Beyzaydinn/LifeLine/README.md

# CEN322 — Offline Voice First-Aid Assistant

**Your hardware only** — no extra push button required.

| Part | Role |
|---|---|
| ESP32-S3-DevKitM-1-N8 | Main controller |
| INMP441 | Microphone (I2S) |
| MAX98357A + 4Ω speaker | Voice output (I2S) |
| MAX30102 | Heart rate / SpO2 (I2C) |
| WS2812B ×8 ring | Status LEDs |
| PC | USB-UART (CP210x/CH9102 bridge) — AI + **graphical interface** |

## Wiring

| Module | GPIO | Power |
|---|---|---|
| INMP441 SD / SCK / WS | 2 / 41 / 42, L/R→GND | 3.3 V |
| MAX98357 DIN / BCLK / LRC / SD | 7 / 5 / 6 / 10 | 5 V VBUS |
| MAX30102 SDA / SCL / INT | 8 / 9 / 4 | 3.3 V |
| NeoPixel DIN | 38 (+330 Ω) | 5 V VBUS |

- **DATA port** (CP210x/CH9102 USB-UART bridge, 921600 baud): `idf.py -p COMx flash` + the PC app `python gui.py` — carries the framed binary protocol
- **LOG port** (USB-Serial-JTAG): `idf.py -p COMy monitor` — ESP logs only

## 1. Flash firmware

```powershell
cd firmware
idf.py set-target esp32s3
idf.py -p COMx flash monitor
```

## 2. Run PC app (GUI)

```powershell
ollama pull llama3.2:3b
cd pc
python -m venv .venv
.\.venv\Scripts\activate
pip install -r requirements.txt
python gui.py
```

1. **Connect** (CP210x/CH9102 DATA COM port)
2. **Read vitals** — finger on MAX30102
3. **Start recording** → speak in English
4. **Stop and analyze** → hear reply on speaker

CLI: `python main.py --port COMy` then `s` start, `e` end.

## Project layout

```
firmware/     ESP-IDF
pc/           gui.py, main.py, stt, llm, tts
wokwi/        diagram + link
```

## Wokwi

Upload `wokwi/diagram.json` and `wokwi/sketch.ino` to [Wokwi](https://wokwi.com), save, and put the project URL in `wokwi/project_link.txt`.  
NeoPixel uses GPIO 38 (matches `config.h`). Potentiometer / buzzer / MPU6050 are stand-ins for INMP441 / speaker+MAX98357 / MAX30102. Real system: `firmware/` + `pc/gui.py`.

## LMS

- `firmware/` (ESP-IDF, not .ino)
- `wokwi/project_link.txt`
- `README.md`
