Beyzaydinn/LifeLine/wokwi/project_link.txt

LifeLine — Wokwi project (CEN322 simulation)
https://wokwi.com/projects/464462040095424513

Contains: diagram.json + sketch.ino (NeoPixel FSM status demo; stand-in parts —
slide-potentiometer = INMP441 mic, buzzer = MAX98357A + speaker, MPU6050 = MAX30102).
The real working system is the ESP-IDF firmware in firmware/ + the PC app in pc/.
