Beyzaydinn/LifeLine/docs/instructions/homework_instructions.md

Hocanın microsoft teams ortamına attığı Final ödev yönergeleri şu şekilde:

Course: CEN322 – Internet of Things
Instructor: Assoc. Prof. Yıldıran YILMAZ
Submission Deadline: 01 JUNE 2026, 23:59
You have to use project report.docx given to you.
Part 1 (LO1)    IoT System Architecture (local edge device), hardware/software explanation    50
Part 2 (LO2)    Circuit design (Wokwi), code, local command recognition, results    50
TOTAL        100
Deliverables (Submit as file named: CEN322_Project_YourName_YourSurname.docx)
The submission must contain:
Project Report (PDF or DOCX) – following the provided Project Assignment Format (fully local version).
Must include: Cover page, Table of Contents, Part 1 (Sections 1–3), Part 2 (Sections 4–10).
Must include a Wokwi circuit diagram (screenshot or live link).
Must include a pin connection table and code snippets.
Arduino Code (.ino file) – fully commented, no API keys, no network code.
Wokwi Project Link (as a .txt file) or a screenshot of the circuit.
README file (.txt or .md) – explaining how to upload the code, wire the components, and test the system (no API configuration needed).
do not use .zip file
Submission Instructions
Prepare the docx file as described above.
Upload to the course LMS before the deadline.
Late submissions: 10% deduction per day (max 3 days).
