Beyzaydinn/LifeLine/(commit log)

2026-05-26 TTS sakin tempo + I2S chipmunk fix + playback flow control
    Kullanicinin "hoparlor sesi cok hizli" istegine yavaslatma uygulayinca
    iki latent bug ortaya cikti, hepsini birlikte coztuk.
    TTS yavaslatma (orijinal istek):
    - pc/tts.py: Piper SynthesisConfig(length_scale=1.25), cumleler arasi
    450ms sessizlik (Piper 1.2+ sentence_silence parametresini kaldirdi,
    cumle-basina-chunk garantisi ile manuel sifir-byte injekte ediyoruz).
    - Spec: docs/superpowers/specs/2026-05-26-tts-calm-pace-design.md
    I2S audio output (chipmunk fix):
    - audio_output.c: data=32, slot=32, STEREO + mono->L+R duplicate
    (audio_input.c ile birebir simetrik). Eski data=16/slot=32/mono
    override'i ESP-IDF v5 driver auto-pa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
    [_test_esp_playback.py, _test_tts_calm.py, audio_output.c, config.h, main.c, serial_bridge.py, tts.py]
2026-05-28 CLAUDE.md ekle: proje oryantasyonu + build/test komutlari
    Yeni Claude Code oturumlarinin hizli baglanmasi icin: iki makineli mimari
    (ESP firmware + PC app), iki-duzlemli I/O (UART data + USB-JTAG log),
    build/flash/monitor + PC test komutlari, kritik ses formati detaylari
    (STEREO 32-bit I2S, real-time pacing, TTS length_scale), AES/ESP-IDF/offline
    kisitlari.
2026-05-28 Accelerate Whisper STT on GPU with CPU fallback
    - stt.py: try CUDA int8_float16 first, fall back to CPU int8 on any failure;
    put the nvidia cuBLAS DLL dirs on PATH (CTranslate2 loads cublas by name);
    warm-up at load to surface GPU errors early; thread-safe _get_model (double-
    checked lock) plus a prewarm() helper.
    - gui.py: pre-warm the model in a background thread at startup.
    - requirements.txt: add nvidia-cublas-cu12.
    - Translate touched code/comments/logs to English; rewrite CLAUDE.md in English
    and document the Whisper GPU path and a language convention.
    Transcribe drops ~1.87s -> ~0.16s on RTX 3050; coexists with Llama (~3.2/4 GB VRAM).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
    [gui.py, stt.py]
2026-05-28 Revise first-aid system prompt; remove the medical-diagnosis disclaimer
    - system_prompt.txt: calm, directive, action-first tone; handle injured-person
    vs helper; concrete vitals prioritization (low SpO2 -> airway/breathing);
    unclear/non-emergency handling; localize the emergency number to 112.
    - llm.py: remove the "not a medical diagnosis" disclaimer entirely (both the
    unconditional append and the sentence in the Ollama-error fallback).
    Note: diverges from proje_plani_ve_mimari_v2.md section 14, which still
    describes the closing disclaimer as mandatory.
    [llm.py]
2026-05-28 Add design spec for honest on-ESP heart-rate (PPG) measurement
    Replace fabricated modulo BPM/SpO2 with a real PPG pipeline computed on
    the ESP32: continuous FIFO sampling, beat detection for heart rate, and
    the standard ratio-of-ratios SpO2 as a labelled estimate. No protocol
    change; the existing 4-byte MSG_SENSOR is kept.
2026-05-28 Add implementation plan for honest on-ESP heart-rate measurement
    Bite-sized tasks: pure PPG DSP core with boot self-test, continuous
    MAX30102 sampler in sensor.c, PC windowed measure_vitals with a
    unit-tested stability helper, and a GUI progress flow.
2026-05-28 Harden ppg_compute: guard non-positive n/fs; clarify SpO2 AC comment
    Code-review follow-up: make the public ppg_compute contract self-defending
    against n<=0 / fs<=0 (avoids an out-of-bounds read on a zero-length window)
    before sensor.c becomes the real caller, and note why SpO2 uses the raw
    (unsmoothed) AC for both channels.
    [ppg.c]
2026-05-28 Tidy sensor.c: drop unused include, dead macros; cast log args
    Code-review follow-up: remove the now-unused <string.h> (memset is gone),
    delete the unreferenced REG_INTR_STATUS_1/2 macros, and cast the uint16/
    uint8 vitals to unsigned for the %u format specifiers.
2026-05-28 Add windowed measure_vitals with unit-tested stability helper
    [_test_measure_settle.py, serial_bridge.py]
2026-05-28 Polish measure_vitals: type on_update, guard need<=0, boundary tests
    Code-review follow-up: annotate the on_update callback (matches the file's
    Callable convention), make vitals_stable total for need<=0, clarify the
    docstring ("at least settle_s"), and add tolerance-boundary + nonpositive-need
    unit tests.
    [_test_measure_settle.py, serial_bridge.py]
2026-05-28 Surface vitals-measurement errors; guard progress divide-by-zero
    Code-review follow-up: add an except block to the measurement worker (matching
    _stop_analyze) so a serial error mid-measurement is shown to the user instead
    of silently dropped, and guard the progress percentage against duration == 0.
    [gui.py]
2026-05-28 Cast %u arg in ppg self-test log for format consistency
    Final-review nit: match sensor.c by casting the uint16_t heart_rate to
    unsigned for the %u specifier in the self-test log line.
2026-05-28 Sensor: 16384nA ADC range, finger-gated buffer, publish invalid w/o finger
    Hardware bring-up of the real PPG path on the MAX30102:
    - SPO2_CONFIG 0x27 -> 0x67 (ADC range 4096 -> 16384 nA). At 4096 nA a firm
    finger saturated the 18-bit ADC at 262143 and clipped the waveform, so no
    beats could be detected.
    - Finger-gate the ring buffer: samples with raw IR below ~50000 (no/partial
    contact) reset the buffer, so the analysis window never straddles the
    baseline->finger onset step that otherwise corrupted the peak threshold.
    - analyze_and_publish now publishes an invalid reading when the buffer is
    empty, so removing the finger immediately clears the vitals.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
    [sensor.c]
2026-05-28 Tune PPG peak detection on real hardware
    Validated against a hand-counted pulse (device ~74 vs manual 76, within +/-5):
    - Skip the high-pass startup region (~1 s) so the finger-onset transient does
    not dominate the peak threshold for a full window.
    - Refractory 0.30 -> 0.50 s to reject the dicrotic notch (it was doubling the
    rate to ~150); caps HR at ~120 BPM, fine for a resting first-aid demo.
    - HP pole 0.995 -> 0.97 (~0.24 Hz) to remove the slow baseline rise as finger
    contact firms up.
    - Peak gate 0.40 -> 0.30 and IBI CV gate 0.25 -> 0.40 so respiration-modulated
    beats and natural beat-to-beat variation do not flicker the reading to
    invalid; the median IBI keeps the value accura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
    [ppg.c]
2026-05-28 Widen vitals measurement window/tolerance for real-sensor behaviour
    On hardware the reading takes ~12 s to settle (finger contact firms up) and
    jitters ~+/-6 BPM around the true rate. Extend measure_vitals to 20 s and
    accept stability within +/-5 BPM (our accuracy target) so the GUI reliably
    settles instead of waiting forever.
    [serial_bridge.py]
2026-05-28 Feed the measured vitals to the LLM and always assess them
    The LLM was reading bridge.last_vitals(), but during recording the ESP streams
    real-time vitals and the finger is off the sensor, so it always saw an invalid
    reading ("no vital signs data"). Now the GUI remembers the last valid "Read
    vitals" measurement and passes that to the LLM. The system prompt instructs the
    model to briefly assess the heart rate and SpO2 (normal/low/high) in every
    reply, and llm.py labels SpO2 as an uncalibrated estimate.
